himikat123/Clock/README.md

# Very simple WiFi clock based on ESP8266 and (TM1637 or MAX7219)
## Clock BIM
<p align="center">
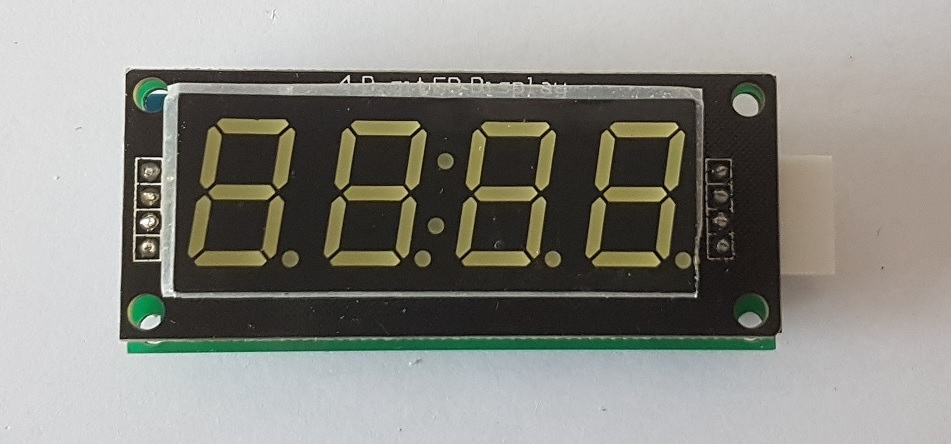
[picture p1: img/clock2.jpg]
WiFi clock BIM
  
</p>

* Minimum details. 3 modules and 7 SMD components.
* The clock keep good time with Internet access. Thanks to synchronization with NTP server.
* Automatic daylight saving time only if needed.
* Decreased display brightness in night mode.
* Ability to set the time and brightness of night and day mode.
* Ability to connect 1 or 2 displays at once and choose what to show where.
* Display the temperature, humidity and pressure from wired sensors, from thingspeak.com and a weather forecast website.
* Sending data to thingspeak.com.
* Ability of correction of readings of wired sensors.
* Remote access to the settings of the clock, via web-interface.
* Simple and understandable even to an unprepared person settings.
* Ability to update the firmware over the air.

## Schematics diagram
<p align="center">
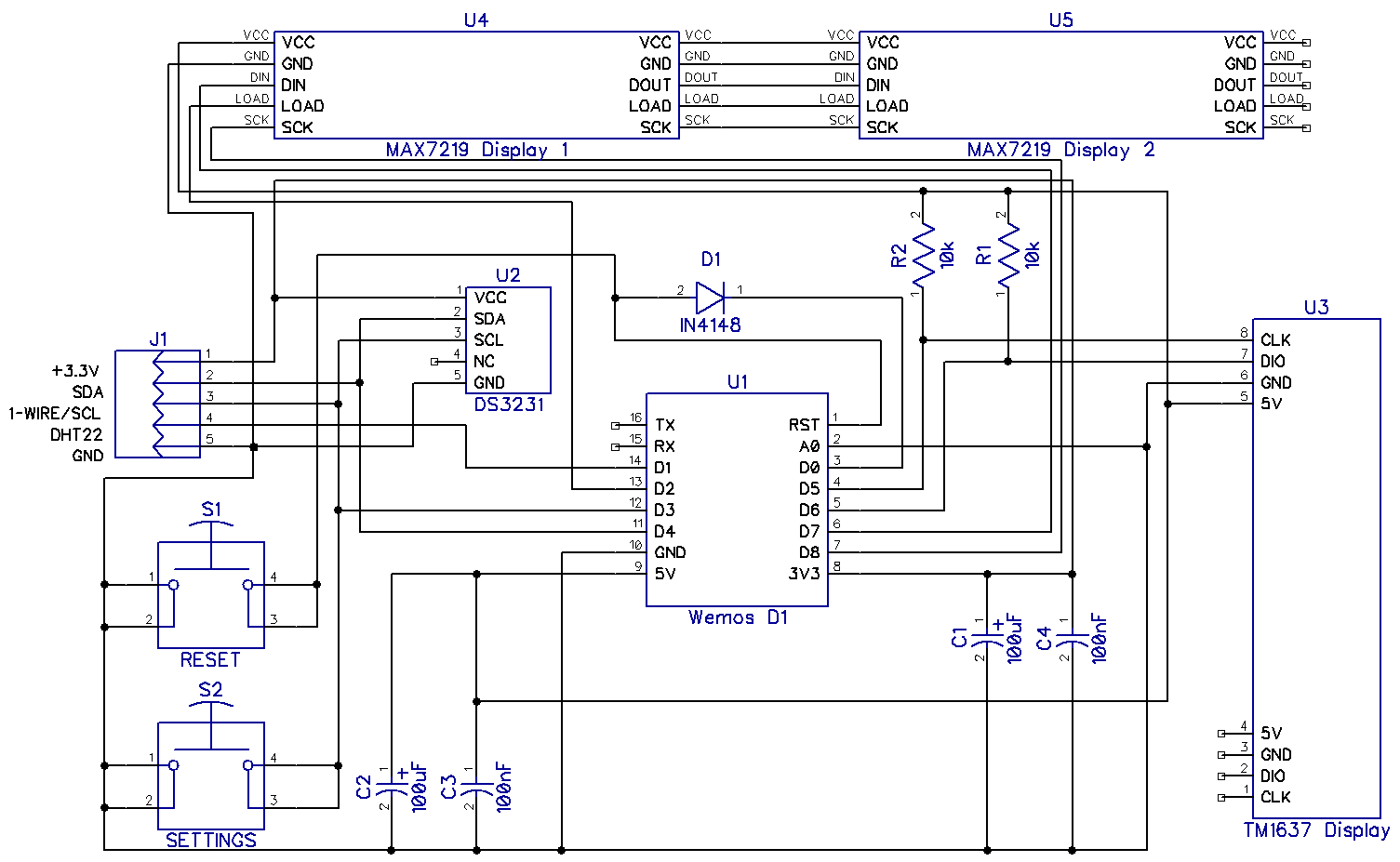
[picture p2: schematic/clock_v3.0.png]
WiFi clock BIM schematics
  
</p>

<b>U1</b> is the heart of the clock this is <b>Wemos D1 mini</b> module, it is a module on an <b>ESP8266</b> chip with all the necessary environment besides a <b>USB -> UART</b> converter and a <b>3.3V</b> converter are built into this module.
<p align="center">
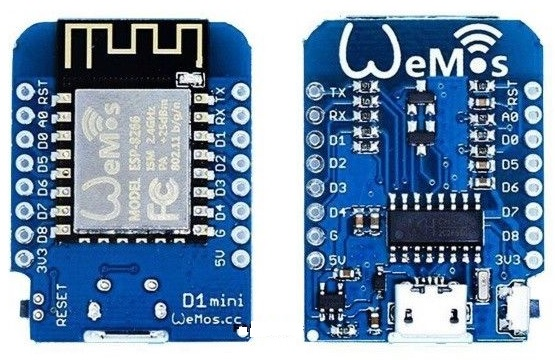
[picture p3: img/wemos.jpg]
wemos D1 mini
  
</p>
The <b>U3</b> display is a 0.5-inch 7-segment LED display module with an integrated <b>TM1637</b> display control chip. Of course you can use the display and a smaller or bigger size but the board is made for this size. You can also use such a display with 6 digits, then seconds will be displayed. You can also apply a 6 or 8 digits display at MAX7219.
<p align="center">
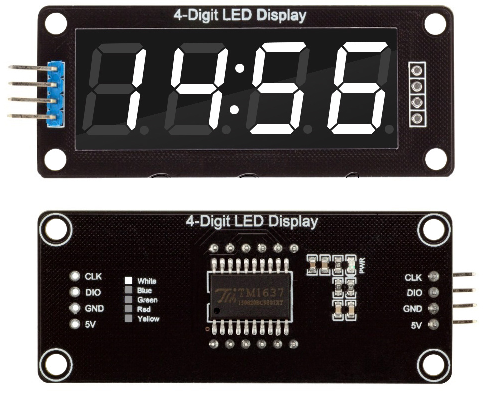
[picture p4: img/tm1637.png]
  
</p>
The <b>U2</b> clock module on the <b>DS3231</b> chip is needed to support the clock in the event of the loss of the Internet. This module can be not installed if you have a stable Internet. Firmware will determine for itself whether the clock module is installed or not.
<p align="center">
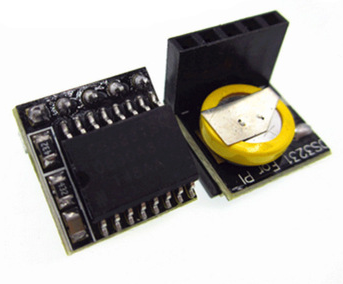
[picture p5: img/DS3231.png]
  
</p>
Resistors <b>R1</b> and <b>R2</b> are only needed if you use a TM1637 display. The diode <b>D1</b> is used to protect the pins of <b>ESP8266</b> from overload. You can replace it with a jumper but it is unsafe. Filtering capacitors <b>C1</b>-<b>C4</b> can be not installed but then possibly unstable clock's work, freezes, malfunctions. The buttons <b>S1</b> and <b>S2</b> are needed accordingly for resetting and entering the clock into the settings mode. Buttons as you may have guessed can also not be installed. <b>J1</b> connector is used to connect the temperature, humidity and pressure sensors. Sensors should be located at a distance of at least 10 cm from the clock since the clock in operation is slightly warm and the sensors are very sensitive. If you don’t need temperature, humidity and/or pressure indications then you can not install the sensors respectively <b>J1</b> connector will not be needed either.
<hr>
The clock supports the following sensors: <b>BME280</b>, <b>BMP180</b>, <b>SHT21 (HTU21D)</b>, <b>DHT22</b> and <b>DS18B20</b>. You can connect one or all the sensors together. In the settings you can choose which sensor where and when to display. The sensors are connected to connector <b>J1</b>, the pin assignment is shown in the schematics diagram.
<hr>
You can power the clock by any charger from the mobile phone with a voltage of <b>5V</b> rated for a current of at least <b>0.5A</b> with a <b>micro USB</b> connector.
<hr>
<p align="center">
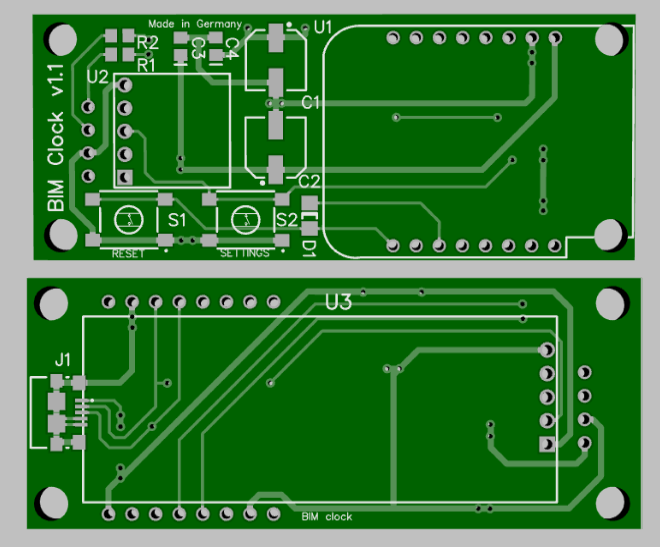
[picture p6: img/clock_pcb_v1.1.png]
PCB for WiFi clock BIM
  
</p>
<hr>
<a href="https://www.youtube.com/watch?v=i8bDxqybWVA&feature=youtu.be" target="_blank">
  <p align="center">
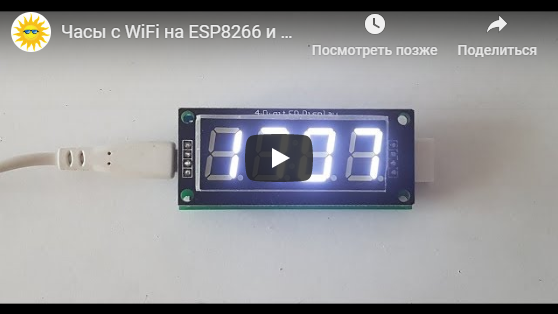
[picture p7: img/youtube.png]
WiFi clock BIM in youtube
    
  </p>
</a>
<hr>
After assembly and flashing the clock needs to be set up. When you first turn on the clock themselves enter the settings mode. In the future, you can go to the clock settings by using the clock's ip address. Connect your laptop or smartphone to the network <b>Clock</b> password is <b>1234567890</b> and in the browser go to <b>http://192.168.4.1</b> address.
The default username is <b>admin</b> the password is <b>1111</b>.
<p align="center">
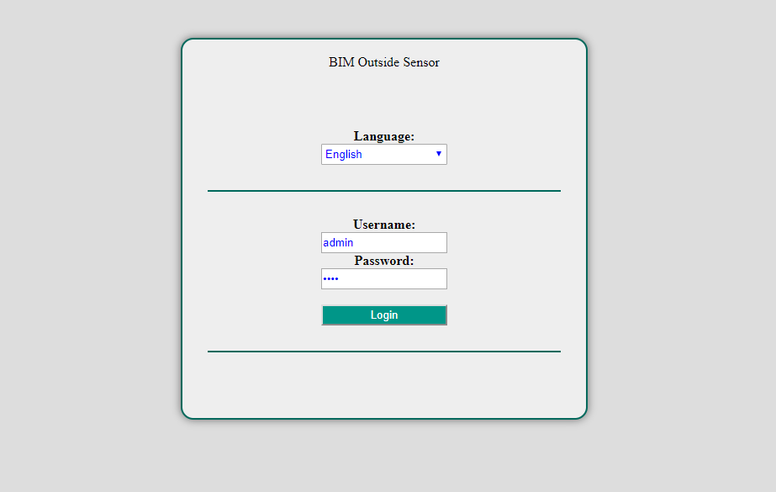
[picture p8: img/login.png]
WiFi clock BIM Login
  
</p>
<p align="center">
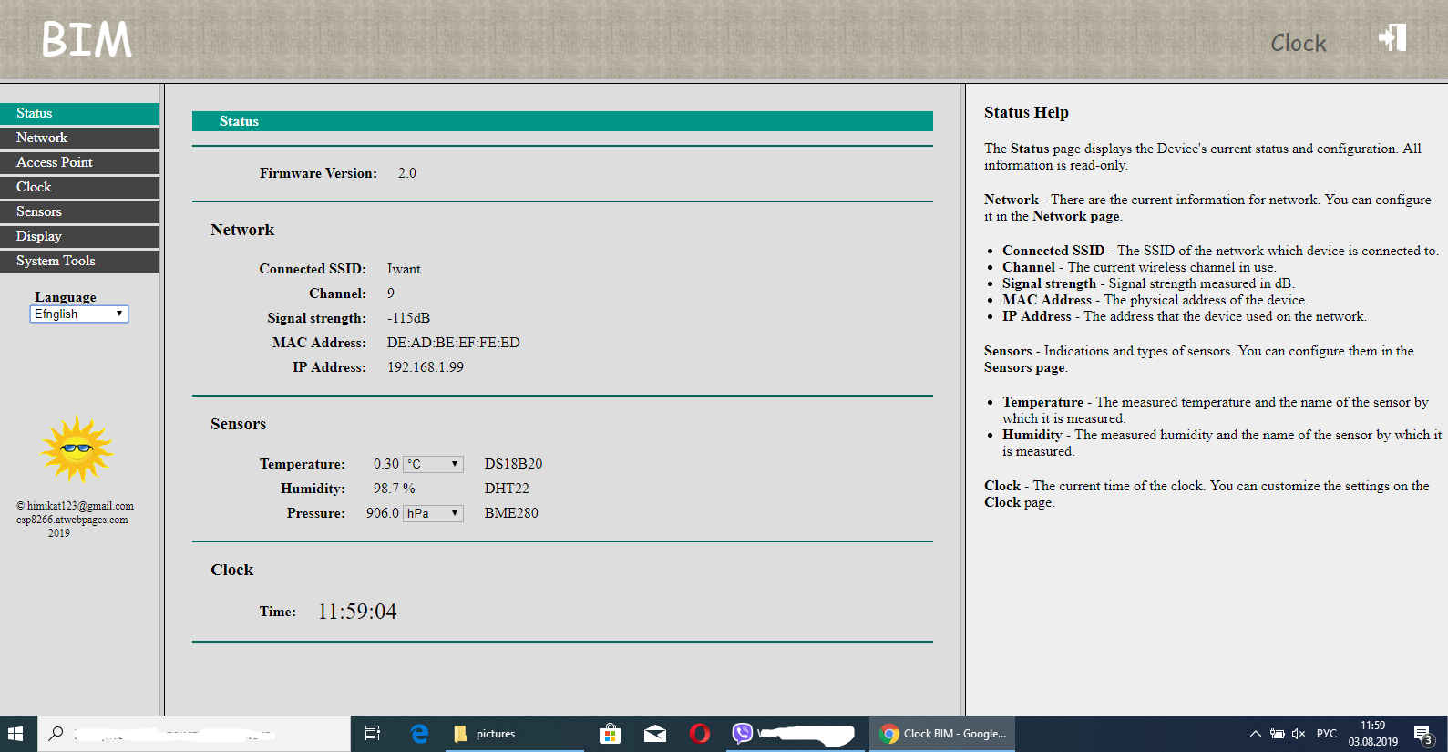
[picture p9: img/sett.png]
WiFi clock BIM Settings
  
</p>
