himikat123/Clock/img/clock3.jpg

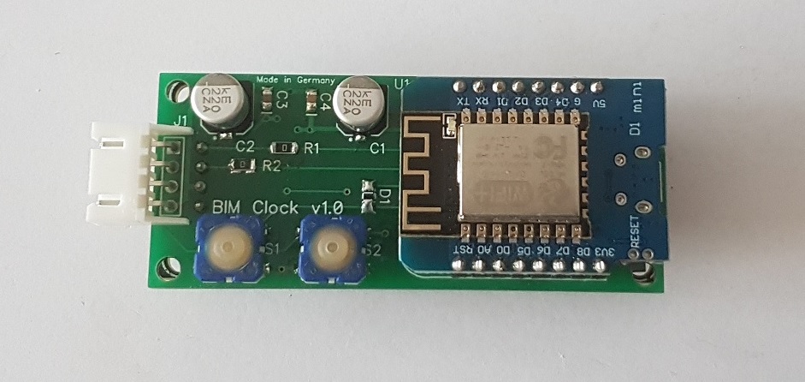
img/clock3.jpg
