himikat123/Clock/img/clock4.jpg

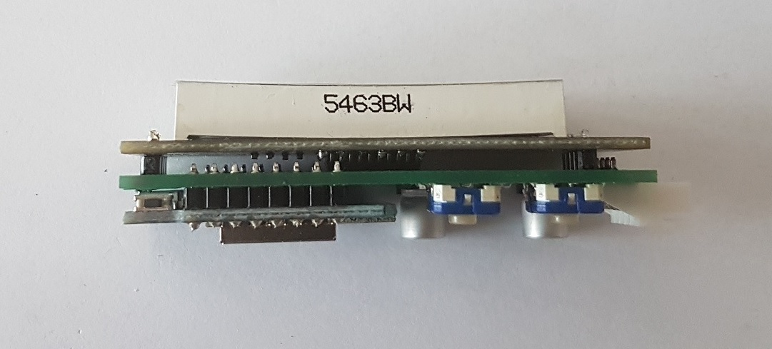
img/clock4.jpg
