himikat123/Clock/img/clock5.jpg

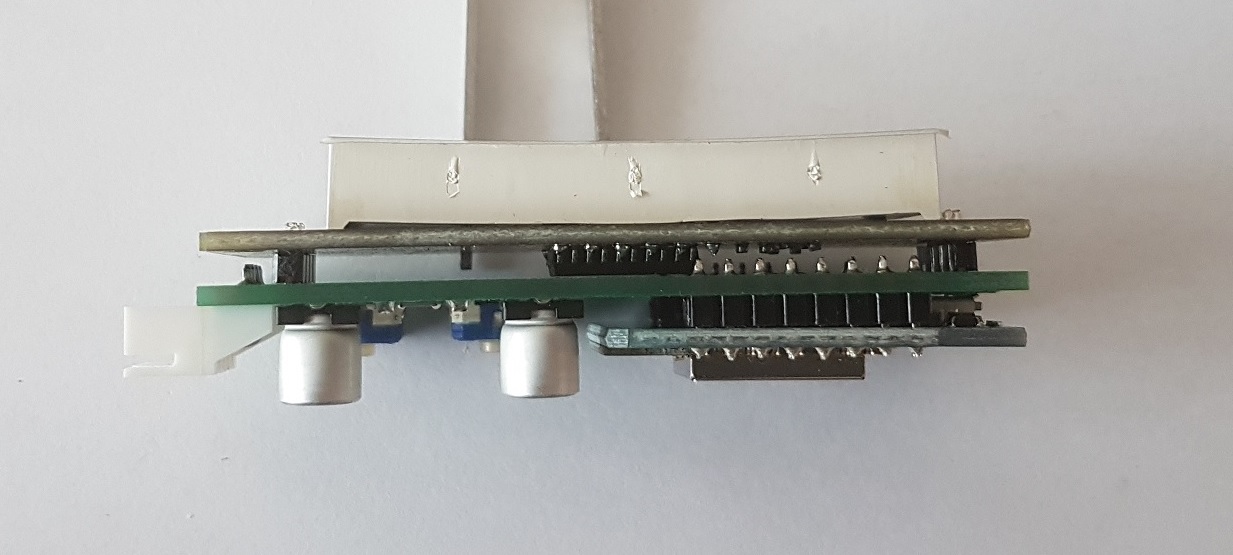
img/clock5.jpg
