himikat123/Clock/img/clock6.jpg

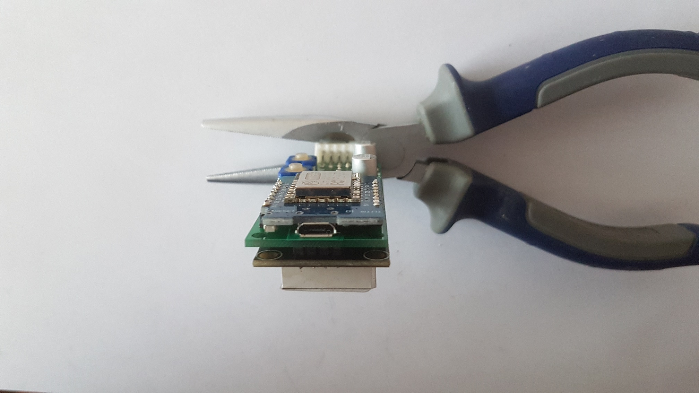
img/clock6.jpg
