himikat123/Clock/img/clock7.jpg

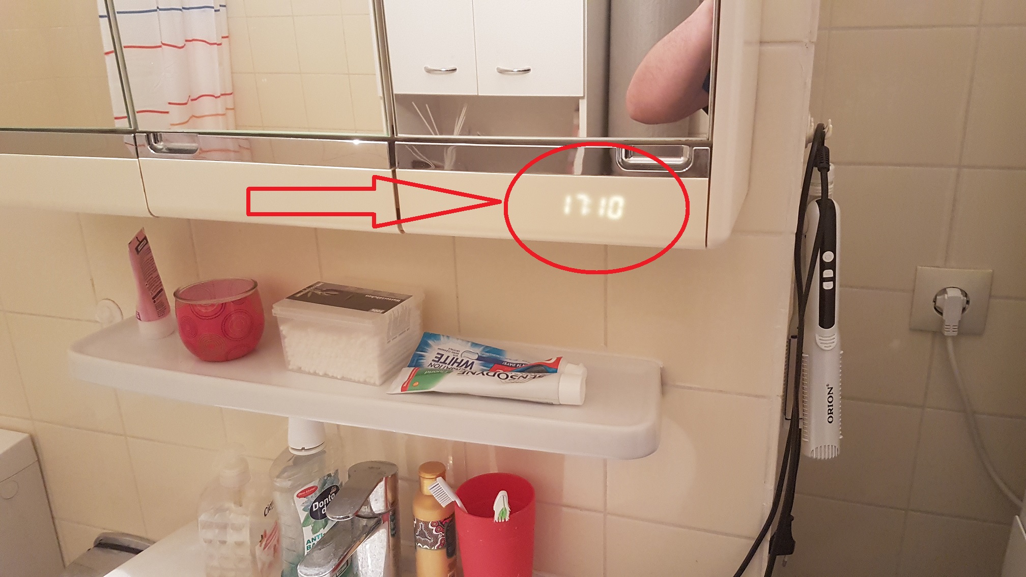
img/clock7.jpg
