himikat123/Clock/schematic/clock_v1.0.gif

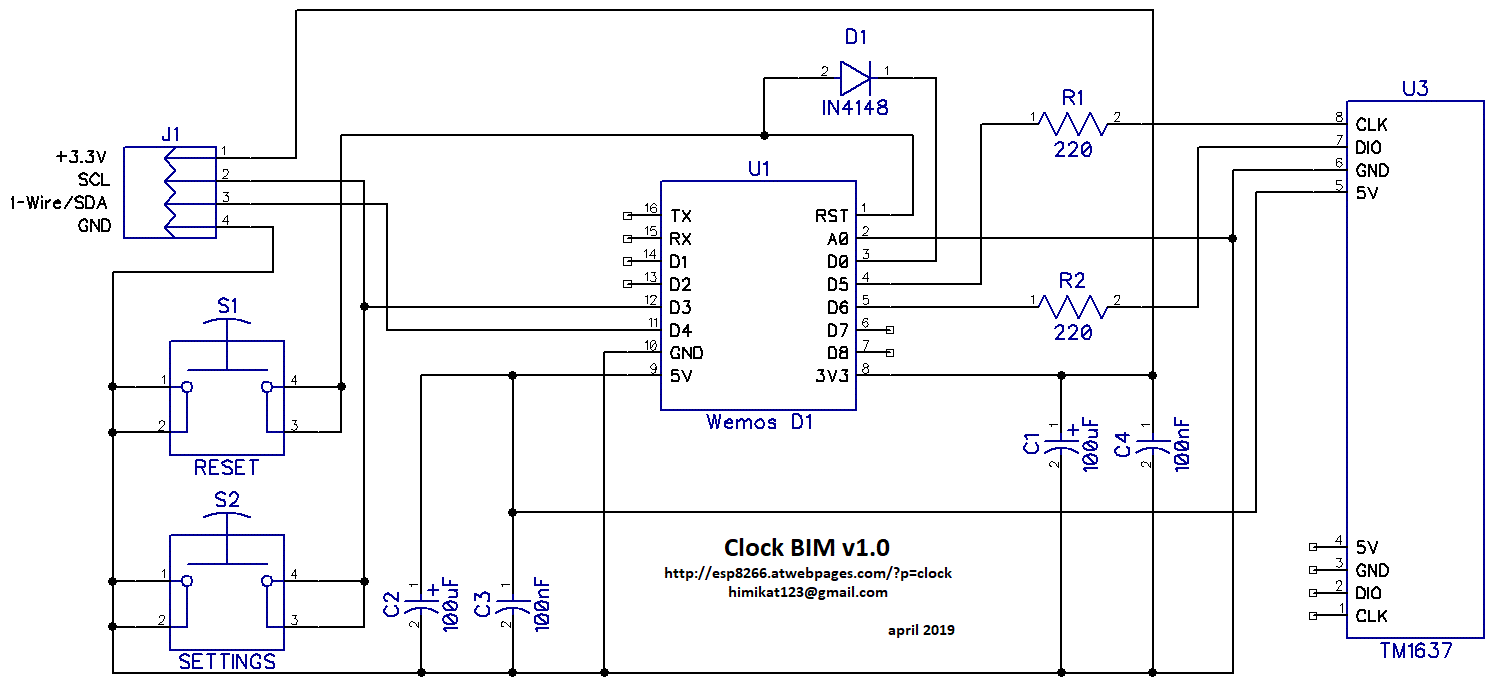
schematic/clock_v1.0.gif
