himikat123/Clock/schematic/clock_v1.1.gif

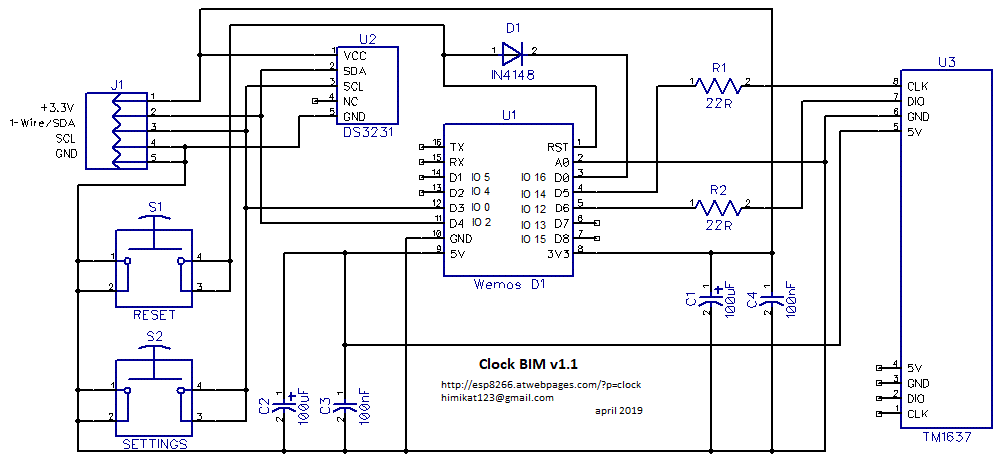
schematic/clock_v1.1.gif
