himikat123/Clock/schematic/clock_v2.0.png

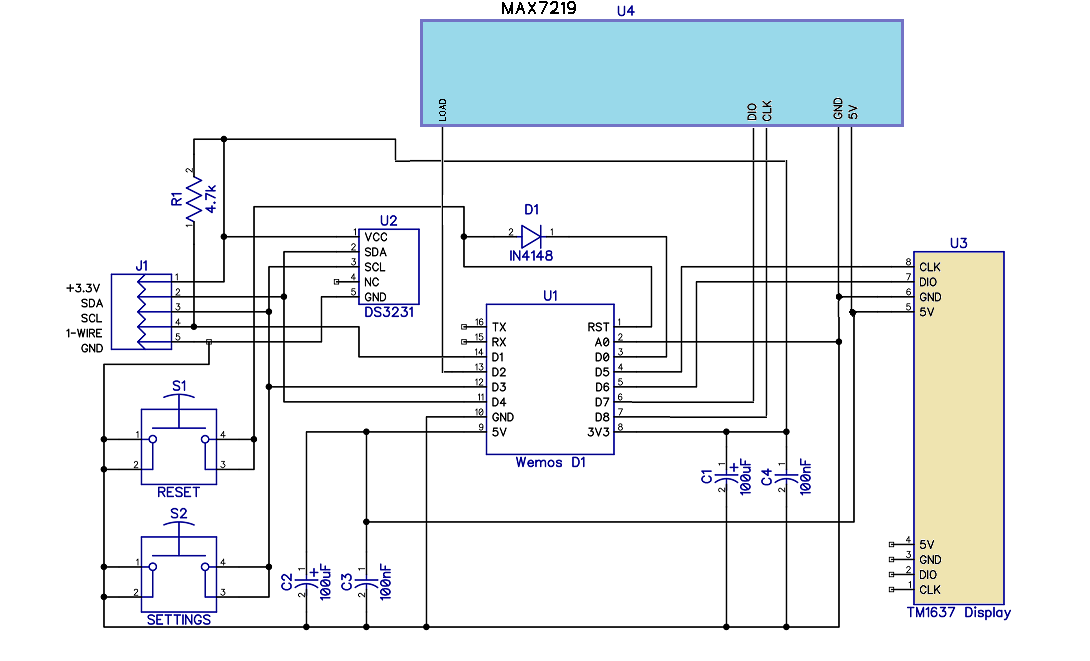
schematic/clock_v2.0.png
