himikat123/Clock/(threads)

Thread 1 (2019-05-15):

Вопрос по работе прибора

star003, 2019-05-15:
Нашел пару интересных недостатков.
1. Если имя сети например ssswifi++ , как у меня на работе - то ++ программа категорически не запоминает.
2. Кнопка SETTING работает только если часы подсоединены к точке доступа.
    Если мы их принесли в другое место , то часы настроить практически невозможно, пока не подключатся к известной сети.
3. Если нет интернета то время застывает на одном положении и не считает

himikat123, 2019-05-19:
Спасибо.
Все исправил. Код обновил. Смотрите новую схему и плату.

Closed 2019-05-19.

Thread 2 (2020-01-13):

Уходит в бесконечный ребут

star003, 2020-01-13:
Пишет вот это

плата wemos d1 mini

ets Jan  8 2013,rst cause:2, boot mode:(3,7)

load 0x4010f000, len 1384, room 16
tail 8
chksum 0x2d
csum 0x2d
v8b899c12
~ld

himikat123, 2020-03-30:
Проверяйте монтаж и исправность элементов, похоже что у вас плата ESP не выходит из режима обновления прошивки.

Closed 2020-03-30.

Thread 3 (2022-01-11):

Clock

vadim-7814, 2022-01-11:

guus46a, 2022-12-25:
Hello, why include"clock.h" gives error in clock.ino? I see it in the left of clock.ino, please help. Can't use firmware bexause i use esp allready on print.
