himikat123/Clock/(list of files, drawings)

Other design files:
pcb/Diptrace V3.0 TM1637-4.dip
pcb/Sprint_layout v3.0 TM1637-4.lay6
