himikat123/Clock/languages.h

struct saved_text{
  const char* saved;
  const char* not_saved;
  const char* old_pass;
};

struct saved_text saved[10]={
  "Saved",
  "Not saved",
  "Invalid old password",
  
  "Сохранено",
  "Не сохранено",
  "Неверный старый пароль",
  
  "Salvat",
  "Nu este salvat",
  "Parola veche nevalidă",

  "Gespeichert",
  "Nicht gespeichert",
  "Ungültiges altes Passwort",

  "Išsaugota",
  "Nepasaugotas",
  "Netinkamas senas slaptažodis",
  
  "Salvestatud",
  "Ei salvestatud",
  "Kehtetu vana parool",
  
  "Збережено",
  "Не збережено",
  "Невірний старий пароль",
  
  "Yadda saxlanıldı",
  "Yadda saxlanılmadı",
  "Yanlış köhnə parol",

  "Захавана",
  "Не захавана",
  "Няправільны стары пароль",

  "Запазено",
  "Незапазено",
  "Невалидна стара парола"
};
